OpenAutoDiagnosticTool/oadt-hardware/Jess PCB Draft Uploads/V4 Pre Feedback/README.md

File with Jess V4 upload (pre sponsor feedback)
