OpenAutoDiagnosticTool/oadt-hardware/Jess PCB Draft Uploads/V4.5 Pre Feedback/V4.5 Schematic.png

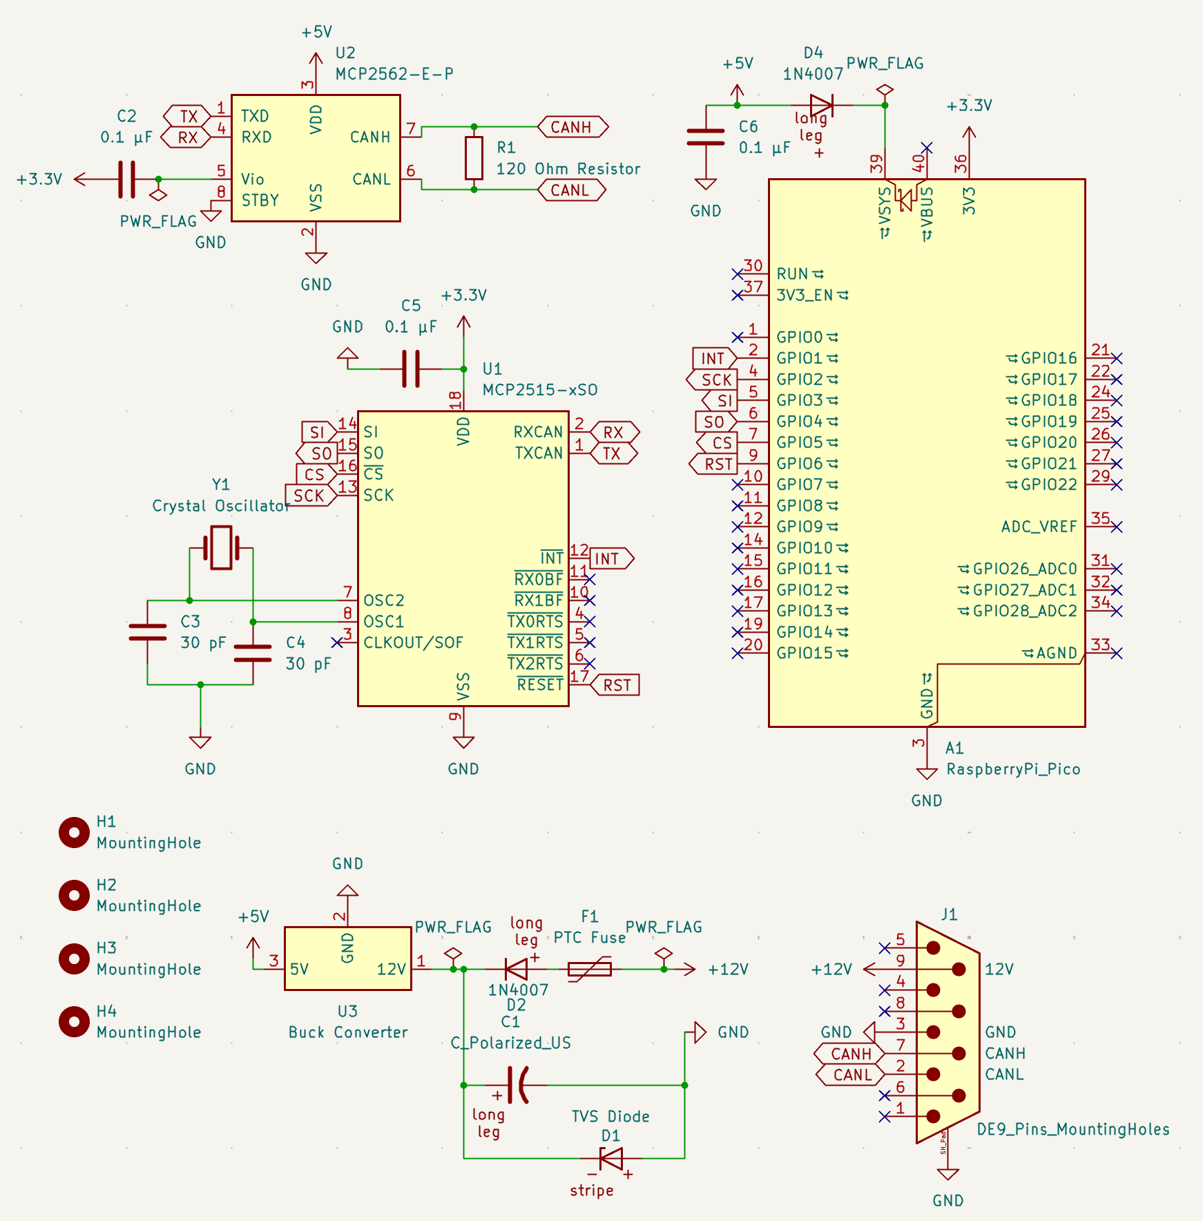
Jess PCB Draft Uploads/V4.5 Pre Feedback/V4.5 Schematic.png
