OpenAutoDiagnosticTool/oadt-hardware/Jess PCB Draft Uploads/V6.75 Post Round 1 Feedback/V6.75 PCB.png

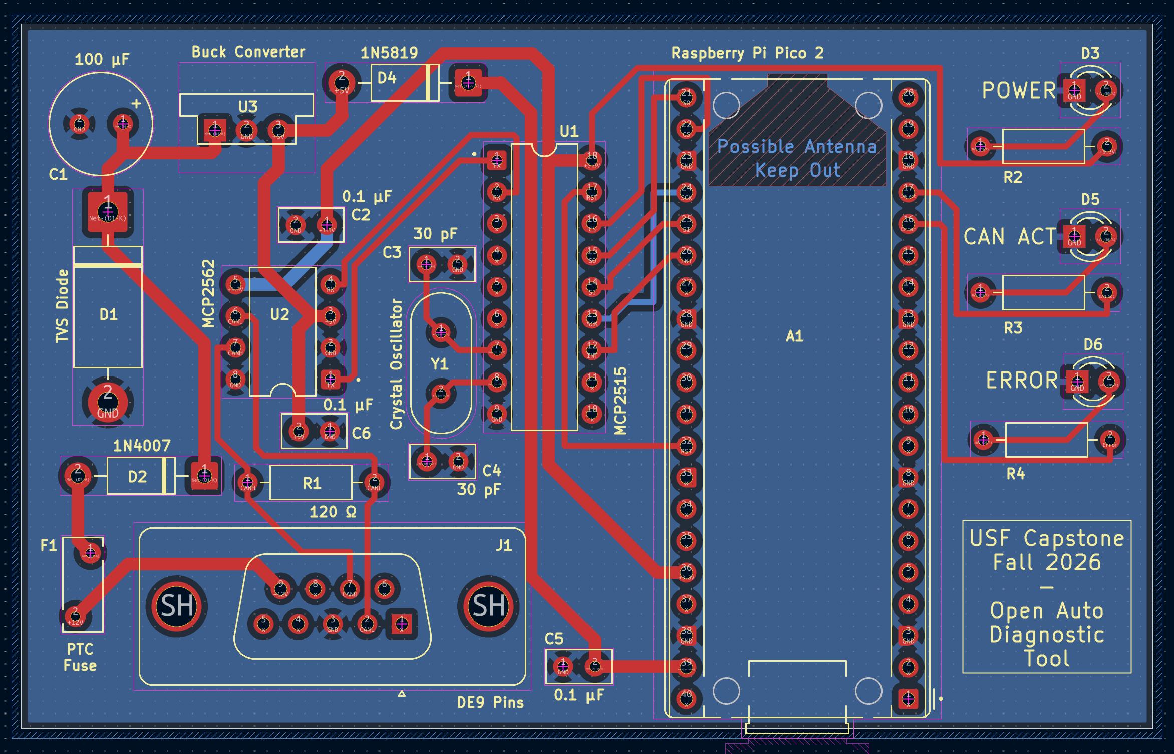
Jess PCB Draft Uploads/V6.75 Post Round 1 Feedback/V6.75 PCB.png
