OpenAutoDiagnosticTool/oadt-hardware/Sri PCB Draft Uploads/Automotive Diagnostic Device Schematic.png

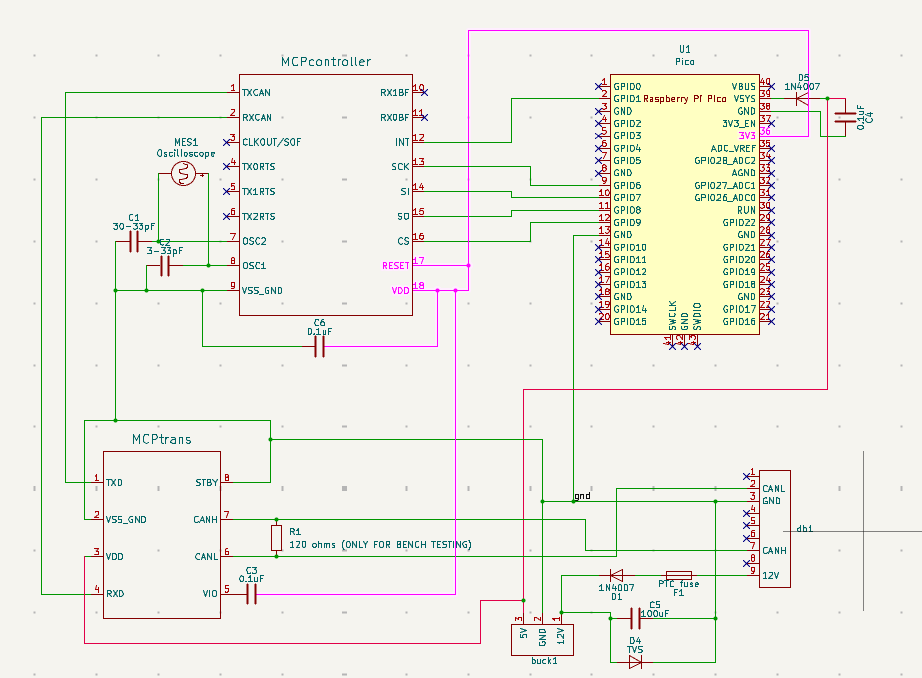
Sri PCB Draft Uploads/Automotive Diagnostic Device Schematic.png
