OpenAutoDiagnosticTool/oadt-hardware/Updated BOM 11_10_26.xlsx

Sheet: DOCUMENTS
Date | File | Notes
2026-09-01 | Capstone - 9/1 (https://docs.google.com/document/u/0/d/1Gs7xZhQPVx7Znyp6BOKTVCD1h0s4Dx-aLEvyEM8XXXg/edit) | First meeting with CyberEthos and HackerBox
2026-09-01 | Individual Milestone 1 (https://docs.google.com/document/u/0/d/1TAU1LhzQIUigBskgj52EvdWvoHsRghSwzVuRf5ABwEk/edit) | Individual Milestone 1 working doc with draft of goals
2026-09-03 | 9/3/26 Meeting Notes (https://docs.google.com/document/d/1-k9ugLh2BX3kCwyq8SMfbWg3F0UrVttjpxOlG3I75LM/edit) | BOM notes,
2026-09-03 | HW research week 2 (https://docs.google.com/document/u/0/d/1gD4UBUJpHWkavbMV75tDN7-YPKfnvkqKcxwa5hba6jA/edit) | research into power regulation and protection circuitry and for hw requirements
2026-09-04 | SRS Document - Group 9.docx (https://docs.google.com/document/d/19dAIpIsazuAdUhwxeTNlklljzbKy301O/edit) | SRS Document Due in Week #5 [DO NOT CHANGE, ARCHIVED FOR WEEK #5]
2026-09-04 | Week 3 PPT - Group 9.ppt (https://docs.google.com/presentation/d/1JEXXgFFRat8mtJlsnbYnkg4aMvGq9VBh/edit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) | Powerpoint Presentation Due in Week #3
2026-09-04 | Compiled References Document (https://docs.google.com/document/d/1ZcJcOYrFqZtFeXOmM2PsOt8LyZMZo1tms-zpK2VTVZk/edit?usp=sharing) | Shared Links & Resources Document (put Research Links Here!)
2026-09-04 | Meeting Questions - 9-8-26 (https://docs.google.com/document/d/1W8fk-RmYhKIOYWmYRygqwYv4s0_oB04zhHvXF1aAWfk/edit?usp=sharing) | Compiled questions document for the second sponsor meeting.
2026-09-07 | CSE Project Competitor Research (https://docs.google.com/spreadsheets/d/1viDQ0cnk6YH8ub9xLXvHGgaDz-HQ3stk7HNVZTzYFW0/edit?usp=sharing) | Market competition pros, cons spreadsheet.
2026-09-08 | Group 9 Status Report Week #3.docx (https://docs.google.com/document/u/0/d/1_K-ItI_vFPWTCAXE9CA6uvT8k9aT0zXq/edit) | Group Milestone Doc for Week #3 due 9/9/26
2026-09-08 | Capstone Timesheet (https://docs.google.com/spreadsheets/u/0/d/1Pm0rdnJS20I27uHih6wyGSNtpxomx7rAShTqMR9tzlI/edit) | Timesheet
2025-09-10 |  | HLA: https://drive.google.com/file/d/1Ch_KrxEQaCyk-fuzPMvXRvO8breeS8U3/view?usp=sharing
2026-09-13 | wiring diagram .pdf (https://drive.google.com/open?id=1QmO12eAfBzWXY-dWjmGoFvzyBTcD6x67) | preliminary wiring diagram
2026-09-15 | Sponsor-Group Timeline (https://docs.google.com/spreadsheets/u/0/d/1W-VPYa-jzlQ1ro1LRvJqG7ZidZEr98lkQcJk_G-nlDw/edit) | Sponsor Deliverable Timeline (Requested By Sponsors for Third Meeting)
2026-09-22 | Capstone Meeting 9/22/26 (https://docs.google.com/document/u/0/d/14cD2zF943hpWhe5fSAL3N1_-DaOxZNKaecCtNU4KPd4/edit)
2026-09-22 |  | Canva SRS Graph Link: https://canva.link/p4soid6kv4p797n
2026-09-24 | SRS_PPT_Week_5.ppt (https://docs.google.com/presentation/d/1PXgv63OLHjyN8DWKORF14GGHjIEUAp2l/edit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)
2026-09-28 | Group 9 Team Status Report Week 6 (https://docs.google.com/document/u/0/d/1SpaOilgrShMOlS1x4Hjs6kuFiKvBCBcWqZKIAeQUMtg/edit) | Weekly Team Status Report for Week #6
2026-10-01 | Detailed Design Document - Group 9 (https://docs.google.com/document/d/138Y3n-lF-r_G1akQkxaeDfNgxYNdTVmt/edit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) | Detailed Design Document Week #8
2026-10-04 | OBD-II Simulator Board Unit Testing (https://docs.google.com/document/d/1VLMCR7gnZ4T5RBzsZaPHs1VmE5JWiIFcANQ7vCqX6X0/edit?usp=sharing) | Testing & Inspection Results of Prototype #1 board and eBay simulator board.
2026-10-04 |  | Canva DDD Document Diagrams: https://canva.link/wtoogvrf2o1iumd
2026-10-11 | SRS Document - Group 9 Week #8 (https://docs.google.com/document/d/16McjUAWhfHkmRGsgXDrwKeOUGeZ0pqAyyyVbb0RX9Bc/edit?usp=sharing) | Week #8 SRS Document Update [IF YOU MAKE SIGNIFICANT CHANGES, WRITE A NOTE ON THE DATE & CHANGE FOR DOCUMENT CONTROL]
2026-10-11 | DDD Powerpoint - Week #8.ppt (https://docs.google.com/presentation/d/1w6024NBoLrOZqCJ-UO9ms8tQUPZ017g8/edit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) | Week #8 DDD Powerpoint (Goes Hand-in-Hand with Detailed Design Document)
2026-10-11 | Team 9 AI SRS Review.pdf (https://drive.google.com/file/d/1GgwA1ytYE2KyEzBP-MFHmU6emLuM2K0-/view?usp=sharing) | AI SRS Scoring from Week #5. Professor comment states to make changes according to sections 4 and 8. A few critical ones, mostly pedantic ones.
2026-10-12 | wiring audit.pdf (https://drive.google.com/open?id=1Z6oFn4v9nUcnitlLjsdUewu_gu_mUPZp) | Wiring audit (updated with changes as discussed in messages) to verify component selection and functionality, minor changes as described in doc: 1. VIO of the transceiver should go to 3.3V and needs a 0.1µf cap between VIO pin and the 3.3V source 2. 1N4007 diodes on CAN lines are unnecessary and could cause a drop in forward voltage (just remove) 3. Pins for the Pico were adjusted so all pins are SPI0 (vs split btwn SPI0 and SPI1)
2026-10-28 | Group 9 Team Status Report Week 10 (https://docs.google.com/document/u/0/d/106oGUNc0ujHek6ETwJYNIdHoj76-xSvasCnr04nFAqE/edit) | Weekly Team Status Report for Week #10
2026-11-09 | MVP Powerpoint - Week #12.ppt (https://docs.google.com/presentation/d/1naQPf0ZhSdVPa0Uvq_Tu2lEraDiBlhHj/edit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) | No report is due, just this powerpoint.
2026-11-09 | Detailed Design Document - Group 9 Week #12.docx (https://docs.google.com/document/d/1ZIA3nQWfP9A84pFIWk2JBPvDaXvIvwDa/edit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) | UPDATED VERSION OF DDD - Version #2 for MVP
2026-11-09 | SRS Document - Group 9 Week #12 (https://docs.google.com/document/d/1K19DcBLqgZFpRvsEChOMCQkJBEyk0aBOqODV7sPy9Ck/edit?usp=sharing) | UPDATED VERSION OF SRS - Version #3 for MVP
2026-11-09 | AI DDD Review Doc.docx (https://docs.google.com/document/d/1nC6-_gfiZbEkbPPOt7ErDGADY-UjA9XS/edit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) | AI-Generated DDD Review

Sheet: Availability
Time | Sunday |  |  |  | Monday |  |  |  | Tuesday |  |  |  | Wednesday |  |  |  | Thursday |  |  |  | Friday |  |  |  | Saturday
 | Jake | Jess | Justin | Sri | Jake | Jess | Justin | Sri | Jake | Jess | Justin | Sri | Jake | Jess | Justin | Sri | Jake | Jess | Justin | Sri | Jake | Jess | Justin | Sri | Jake | Jess | Justin | Sri
9 | y | n |  | y | n | n | y |  | n | n |  |  | n | n | y |  | y | n | y |  | y | n | y |  | y | n |  | y
9:30:00 | y | n |  | y | n | y | y |  | n | n |  |  | n | y | y |  | y | n | y |  | y | n | y |  | y | n |  | y
10 | y | y |  | y | n | y | y |  | n | n |  |  | n | y | y |  | y | n | y |  | y | n | y |  | y | y |  | y
10:30:00 | y | y |  | y | n | y | y |  | n | n |  |  | n | y | y |  | y | n | y |  | y | n | y |  | y | y |  | y
11 | y | y |  | y | n | y | y |  | n | y |  |  | n | y | y |  | y | y | y |  | n | n | y |  | y | y |  | y
11:30:00 | y | y |  | y | n | y | y |  | n | y |  |  | n | y | y |  | y | y | y |  | n | n | y |  | y | y |  | y
Noon | y | y |  | y | n | y | y |  | n | y |  |  | n | y | y |  | y | y | y |  | n | n | y |  | y | y |  | y
12:30:00 | y | y |  | y | n | y | y |  | n | y |  |  | n | y | y |  | n | y | y |  | n | n | y |  | y | y |  | y
1 | y | y |  | y | n | y | y |  | n | y |  |  | n | y | y |  | n | y | y |  | n | n | y |  | y | y |  | y
1:30:00 | y | y |  | y | n | y | y |  | n | y |  |  | n | y | y |  | n | y | y |  | n | n | y |  | y | y |  | y
2 | y | y |  | y | n | y | y |  | n | n |  |  | n | y | y |  | n | n | y |  | n | y | y | y | y | y |  | y
2:30:00 | y | y |  | y | n | y | y | y | y | n |  | y | n | y | y | y | n | n | y | y | n | y | y | y | y | y |  | y
3 | y | y |  | y | n | y | y | y | y | n |  | y | n | y | y | y | n | n | y | y | n | y | y | y | y | y |  | y
3:30:00 | y | y |  | y | n | y | y | y | y | n |  | y | n | y | y | y | n | n | y | y | n | y | y | y | y | y |  | y
4 | y | y |  | y | n | y | y | y | y | n |  | y | n | y | y | y | n | n | y | y | n | y | y | y | y | y |  | y
4:30:00 | y | y |  | y | n | y | y | y | y | n |  | y | n | y | y | y | n | n | y | y | n | y | y | y | y | y |  | y
5 | y | y |  | y | n | y | y | n | y | n | n | y | n | y | y | y | n | n | y | y | n | y | y | y | y | y |  | y
5:30:00 | y | y |  | y | n | y | y | n | y | n | n | y | n | y | y | y | n | n | n | y | n | y | y | y | y | y |  | y
6 | y | y |  | y | n | y | y | n | y | n | n | y | n | y | y | y | n | n | n | y | n | y | y | y | y | y |  | y
6:30:00 | y | y |  | y | n | n | y | n | y | n | n | y | n | n | y | y | n | n | n | y | n | y | y | y | y | y |  | y
7 | y | n |  | y | n | n | n | n | y | y | n | y | n | n | n | y | n | y | n | y | n | y | y | y | y | n |  | y
7:30:00 | y | n |  | y | n | n | n | n | y | y | n | y | n | n | n | y | n | y | n | y | n | y | y | y | y | n |  | y
8 | y | n |  | y | n | y | n | n | y | y | n | y | n | y | n | y | n | y | n | y | n | y | y | y | y | n |  | y
8:30:00 | y | n |  | y | n | y | n | n | y | y | y | y | n | y | n | y | n | y | y | y | n | y | y | y | y | n |  | y
Notes: | Justin - depends on my work schedule |  |  |  |  |  |  |  |  |  |  |  |  |  |  |  |  |  |  |  |  |  |  |  | Justin - depends on my work schedule

Sheet: Time Tracker
Date | People | Amt of Time (hrs) | Classification | Notes
2026-08-28 | Group | 1 | Meeting | First meeting after class on Friday
2026-08-31 | Jess | 1.5 | Individual Work | Reading about project, research on project requirements
2026-08-30 | Sri | 1 | Individual Work | Reading project document, looked at resources given by sponsors about project, created sheets for team organization
2026-08-31 | Jake | 1 | Individual Work | Reading project document, determining roles, sponsor meeting setup, firmware meeting questions.
2026-08-31 | Justin | 1 | Individual Work | Reading Project doc, and looking into PCB design basics
2026-09-01 | Jess | 2.5 | Individual Work | Determining questions for first meeting, researching requirements, start of goals for individual milestone
2026-09-01 | Group | 0.75 | Meeting | Meeting #1 with sponsors to ask preliminary questions
2026-09-01 | Jess | 0.5 | Individual Work | Making time tracker, coming up with milestone 1 goals, and uploading to notes tab
2026-09-02 | Sri | 2 | Individual Work | research and thinking about prototyping methods+timeline and success
2026-09-02 | Justin | 1 | Individual Work | Going over the timesheet and reflecting on our goals for week 2 report
2026-09-02 | Group | 1-2 on average | Individual Work | Individual Milestone 1 and associated communication
2026-09-03 | Group | 1 | Meeting | Reviwed incompleted goals this week, created goals for next week and next steps to guide work and research.
2026-09-03 | Sri | 2 | Individual Work | Researched OBD2 connector and protection circuitry
2026-09-04 | Jake | 2.5 | Individual Work | Researched CAM Firmware, Project Proposal Resource Links, Made Extra Docs
2026-09-07 | Jake | 2.5 | Individual Work | Created research documents, worked on Epic/Features, meeting questions, competitor market research.
2026-09-08 | Group | 0.75 | Meeting | Sponsor Meeting #2
2026-09-08 | Jake | 2.5 | Meeting | Clarification of Project Requirements, Next Steps, Pi Pico 2W Setup

Sheet: Requirements
Req. ID | Requirement | Rationale (story statement) | Verification method / success metric | Parent Req | Child Req | Status | Notes | Req. ID | Requirement | Rationale (story statement) | Verification method | Parent Req | Child Req | Status
FR - 1.1 | Shall connect to standard OBD-II (SAE J1962) connector. |  |  |  |  | Incomplete | Do we want to be able to interact with OBD2 B vehicles that have a higher voltage? | NFR - 1.1 | Tool shall be easy to connect and operate. |  |  |  |  | Incomplete
FR - 1.2 | Shall support ISO 15765-4 CAN signaling. |  |  |  |  | Incomplete | For Spec: will support this signalling using CAN tranciever built in to Pico board | NFR - 1.2 | Documentation shall be clear for non-experts. |  |  |  |  | Incomplete
FR - 1.3 | Shall provide regulated power from vehicle 12 V supply. |  |  |  |  | Incomplete | Could be 24V will check with sponsor | NFR - 2.1 | Hardware shall withstand automotive electrical conditions |  |  |  |  | Incomplete
FR - 1.4 | Shall include protection against reverse polarity and voltage spikes |  |  |  |  | Incomplete | For spec: need to find out what component is needed to achieve this | NFR - 2.2 | Communication shall maintain stable CAN bus operation. |  |  |  |  | Incomplete
FR - 2.1 | Shall initialize and manage CAN 2.0A/B communication |  |  |  |  | Incomplete | Should we bit bang (use processor directly for comms) or use additional communication chip? | NFR - 3.1 | Firmware shall prevent unintended ECU modification. |  |  |  |  | Incomplete
FR - 2.2 | Shall support message filtering and ID dec |  |  |  |  | Incomplete |  | NFR - 3.2 | Diagnostic commands shall be limited to safe read-only operations. |  |  |  |  | Incomplete
FR - 2.3 | Shall transmit and receive OBD-II diagnostic frames. |  |  |  |  | Incomplete |  | NFR - 4.1 | System shall allow additional protocols (e.g., K-Line, CAN-FD). |  |  |  |  | Incomplete
FR - 3.1 | Shall support OBD-II Modes 01–09. |  |  |  |  | Incomplete |  | NFR - 4.2 | Open-source design shall support community contributions |  |  |  |  | Incomplete
FR - 3.2 | Shall read and clear diagnostic trouble codes (DTCs) |  |  |  |  | Incomplete |  | NFR - 5 | Total BOM cost shall remain under a target threshold (e.g., $75–$100 per unit) |  |  |  |  | Incomplete
FR - 3.3 | Shall display or transmit sensor data (RPM, speed, temperature, etc.). |  |  |  |  | Incomplete
FR - 3.4 | Shall log communication sessions for analysis. |  |  |  |  | Incomplete
FR - 4.1 | Shall allow firmware updates via USB or serial interface. |  |  |  |  | Incomplete
FR - 4.2 | Shall support modular code structure for adding new protocols. |  |  |  |  | Incomplete
FR - 5.1 | Shall provide graphical display of live data and fault codes. | NON NECESSARY |  |  |  | Incomplete
FR - 5.2 | Shall allow data export to CSV or JSON format |  |  |  |  | Incomplete

Sheet: Task Tracker
Task | Priority | Owner | Status | Due date | Milestone | Deliverable | Notes
Bill of Materials | P3 | Justin | In progress | 2026-09-08
Schematic | P2 | Sri | Not started | 2026-09-17
Setup SRS Document | P2 | Jacob Rowe | Completed | 2026-09-05
Complete Week #3 Powerpoint | P1 | Jacob Rowe | Completed | 2026-09-10
Create Week #3 Epic, Features, Stories | P2 | Jacob Rowe | Completed | 2026-09-10
Investigate and document differences between OBD A and B. | P3 | Sri | In progress | 2026-09-10
Investigate making a simulator. | P3 | Jess | Blocked | 2026-09-10
Investigate whether CAN controller within Pico is capable of interfacing with the OBD to the level we need it to. | P3 | Justin | Not started | 2026-09-10
Complete & Present Sponsor Deliverable Timeline Document | P1 | Jacob | Blocked | 2026-09-15 |  |  | Sponsors cancelled the meeting last-minute.

Sheet: BOM New
Item name | Quantity | Price | Status | Supplier | Part Number | Notes | Total Cost
Raspberry Pi Pico 2 | 1 | 6 | Own | Digikey | SC1632 | https://www.digikey.com/en/products/detail/raspberry-pi/SC1632/26241102 | 6
MCP2515-I/P CAN Controller | 1 | 2.71 | need to order | Digikey | MCP2515-I/P-ND | https://www.digikey.com/en/products/detail/microchip-technology/MCP2515-I-P/593000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 | 2.71
MCP2562-E/P CAN Transciever | 1 | 1.31 | need to order | Digikey | MCP2562-E/P-ND | https://www.digikey.com/en/products/detail/microchip-technology/MCP2562-E-P/4079966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 | 1.31
16MHz Crystal Oscillator | 1 | 0.32 | need to order | Digikey | 3155-16M20P2/49US-ND | https://www.digikey.com/en/products/detail/yic/16M20P2-49US/15648595 | 0.32
22pF Capacitor | 2 | 0.26 | Own | Digikey | 445-174269-1-ND | https://www.digikey.com/en/products/detail/tdk/FA28C0G1H220JNU00/7384514 | 0.52
0.1µF Capacitor | 3 | 0.28 | need to order | Digikey | 445-174245-1-ND | https://www.digikey.com/en/products/detail/tdk/FA18X7R1H104KNU00/7384204 | 0.84
100µF Capacitor | 1 | 0.37 | need to order | Digikey | 399-15742-ND | https://www.digikey.com/en/products/detail/kemet/ESL107M050AGMAA/7427057 | 0.37
10k Ohm Resistor | 2 | 0.1 | Own | Digikey | 13-CFR-25JB-52-10K-ND | https://www.digikey.com/en/products/detail/yageo/CFR-25JB-52-10K/338 | 0.2
DC DC CONVERTER 5V Buck Regulator | 1 | 6 | need to order | Digikey | 811-2196-5-ND | https://www.digikey.com/en/products/detail/murata-power-solutions-inc/OKI-78SR-5-1-5-W36-C/2259781 | 6
1N4007 Rectifier Diode | 1 | 0.22 | need to order | Digikey | 5245-1N4007CT-ND | https://www.digikey.com/en/products/detail/dcomponents/1N4007/27607983?utm_source=chatgpt.com | 0.22
1.5KE20A TVS Diode | 1 | 0.9 | need to order | Digikey | 4878-1.5KE20ACT-ND | https://www.digikey.com/en/products/detail/diotec-semiconductor/1-5KE20A/22193463 | 0.9
PTC Resettable FUSE 60V 500MA | 1 | 0.47 | need to order | Digikey | MF-R050-2CT-ND | https://www.digikey.com/en/products/detail/bourns-inc/MF-R050/259965 | 0.47
OBD to DE-9 Cable | 1 | 5.95 | need to order | Digikey | 1528-4841-ND | https://www.digikey.com/en/products/detail/adafruit-industries-llc/4841/13901491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 | 5.95
3mm LED | 3 | 0.16 | Own | Digikey | 732-5008-ND | https://www.digikey.com/en/products/detail/w-rth-elektronik/151031VS06000/4489988?gclsrc=aw.ds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
120 Ohm Resistor | 3 | 0.1 | Own | Digikey | 120QBK-ND | https://www.digikey.com/en/products/detail/yageo/CFR-25JB-52-120R/389?s=N4IgTCBcDaIIxgAwEUBCBpAtAOQCIgF0BfIA
Solderable DB9 | 1 | 0.78 | need to order | Digikey | AE10970-ND | https://www.digikey.com/en/products/detail/assmann-wsw-components/A-DS-09-A-KG-T4S/1241806?gclsrc=aw.ds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
For Prototyping |  |  |  |  |  |  | 0
120 Ohm Resistor [NOTE: This is for bench testing only; if plugging into a car, this MUST be removed!] | 1 | 0.1 | Own | Digikey | 120QBK-ND | https://www.digikey.com/en/products/detail/yageo/CFR-25JB-52-120R/389?s=N4IgTCBcDaIIxgAwEUBCBpAtAOQCIgF0BfIA | 0.1
DB9 to Terminal Block Adapter | 1 | 6.25 | need to order | Digikey | 1528-4512-ND | https://www.digikey.com/en/products/detail/adafruit-industries-llc/4512/12396898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 | 6.25
18-pin DIP Socket for MCP2515 | 1 | 0.98 | need to order | Digikey | 2057-ICS-318-T-ND | https://www.digikey.com/en/products/detail/adam-tech/ICS-318-T/9832865 | 0.98
8-pin DIP Socket for MCP2562 | 1 | 0.69 | need to order | Digikey | 2057-ICS-308-T-ND | https://www.digikey.com/en/products/detail/adam-tech/ICS-308-T/9829299 | 0.69
20-pin Female Headers for Pico | 2 | 1.15 | Own | Digikey | S7018-ND | https://www.digikey.com/en/products/detail/sullins-connector-solutions/PPTC201LFBN-RC/810158 | 2.3
Simulators |  |  |  |  |  |  | 36.13
Thanksbuyer Automotive ECU Simulator (no screen) |  | 40.06 |  | Thanksbuyer | (also available for a similar price on Ebay) | https://www.thanksbuyer.com/products/automotive-ecu-simulator-obd-simulator-with-accessories-for-passenger-cars-elm327-development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
Thanksbuyer OBD II Simulator with Screen |  | 59 |  | Thanksbuyer | (also available for a similar price on Ebay) | https://www.thanksbuyer.com/products/obd-ii-simulator-obd2-ecu-simulator-with-0-96-quot-128-64-oled-screen-supports-7-conventional-protocols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

Sheet: BOM Old
Item name | Part Number | Price | supplier | Status | Notes | Column 1
obd2 to db9 cord |  | 6.9 |  |  | https://www.digikey.com/en/products/detail/dfrobot/FIT0429/7597204
male db9 on board |  | 0.79 |  |  | https://www.digikey.com/en/products/detail/assmann-wsw-components/A-DS-09-PP-Z-BK/10668847?gclsrc=aw.ds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
Soldering Iron |  |  |  |  | Team-supplied
Breadboard |  |  |  |  | Team-supplied
Protoboard |  |  |  |  | Team-supplied
Raspberry Pi Pico 2 |  | 6.25 |  |  | https://www.adafruit.com/product/6006
PPTC Fuse |  | 0.4 |  |  | https://www.mouser.com/en/ProductDetail/Bourns/MF-R050?qs=A6omU7D3gEWzJRzbTsuTwA%3D%3D&mgh=1
Schottky Diode |  | 0.6 |  |  | https://www.digikey.com/en/products/detail/vishay-general-semiconductor-diodes-division/SS1H10-E3-61T/1091541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
TVS Diode |  |  |  |  | https://us.rs-online.com/product/littelfuse/smcj33a/70519330/
Buck Regulator Module |  |  |  |  | https://www.droking.com/DC-Step-Down-Voltage-Regulator-DC-12-24V-to-5V-5A-25W-Buck-Converter-Module-Waterproof-Car-Power-Supply
RECOMMMENDED CAN protocol controller with tranceiver | MCP 25625 | 3.8 | Digikey | need to order | https://www.digikey.com/en/products/detail/microchip-technology/MCP25625-E-SS/4842805
DIP TRANSCEIVER (: | MCP2561-H/P |  | Digikey | need to order | https://www.digikey.com/en/products/detail/microchip-technology/MCP2561-H-P/4079963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
[Jake] CAN-FD Compatible CAN Transceiver | 1 | 1.5 |  | Digikey | MCP2562FD-H/P | https://www.digikey.com/en/products/detail/microchip-technology/MCP2562FD-H-P/4860102
