OpenAutoDiagnosticTool/oadt-hardware/Sri PCB Draft Uploads/Capstone V2 nets.kicad_pcb

## KiCad design Sri PCB Draft Uploads/Capstone V2 nets.kicad_pcb (2026-11-11)

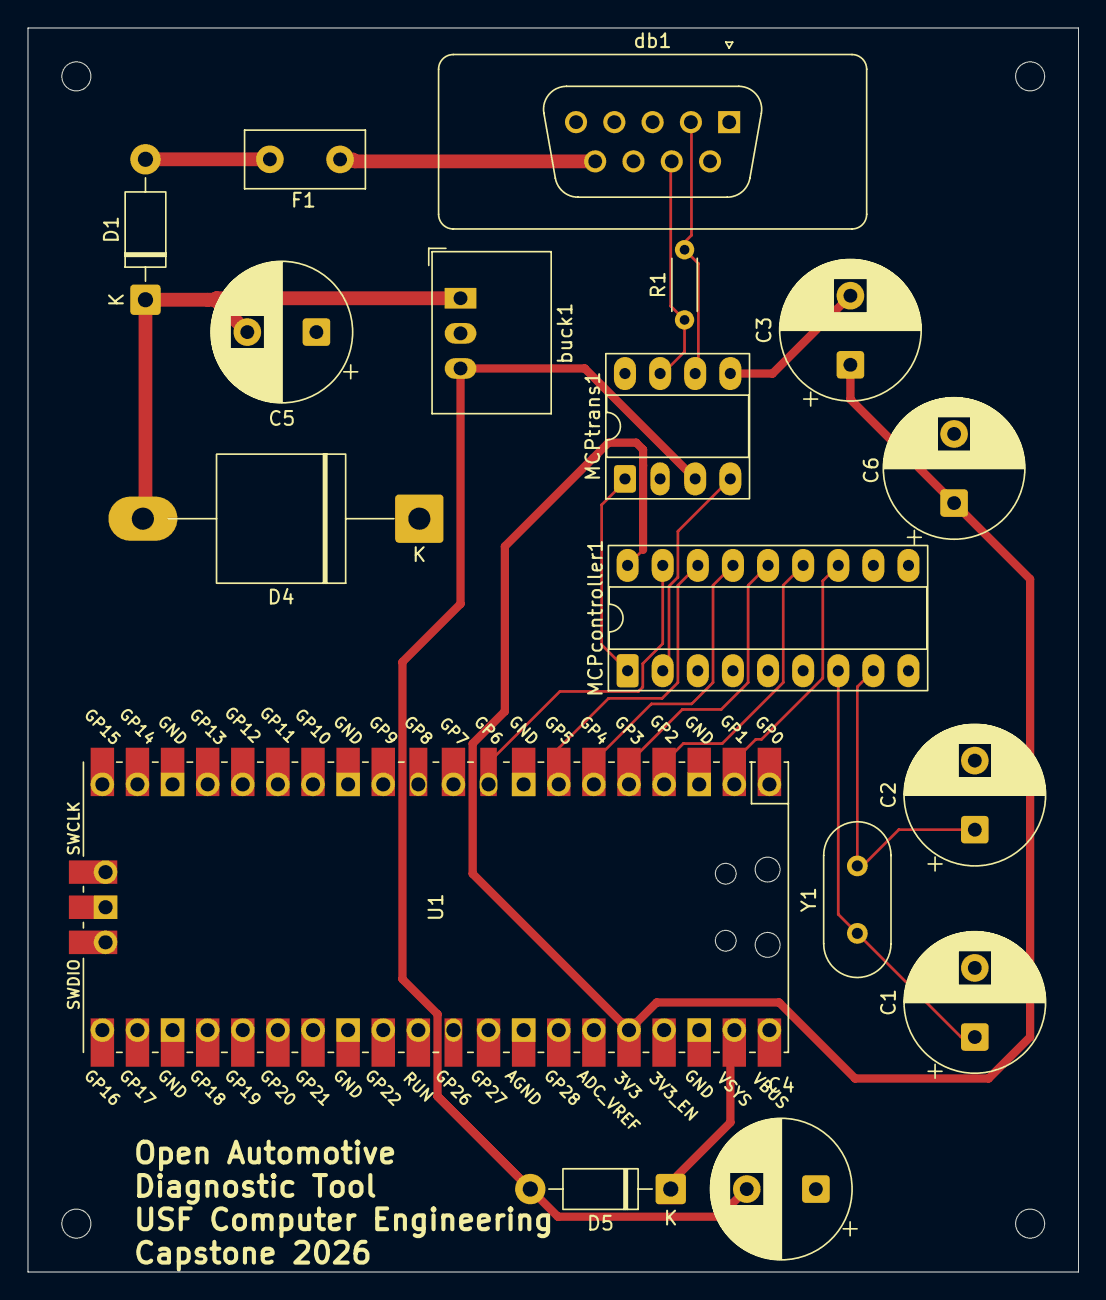
[picture p6: board Capstone V2 nets.kicad_pcb from above]

Board: 2 copper layers, 76.0 x 90.0 mm, 17 parts (0 on the bottom side), 20 nets.

Parts:
C1: 30-33pF; CP_Radial_D10.0mm_P5.00mm
C2: 3-33pF; CP_Radial_D10.0mm_P5.00mm
C3, C4, C6: 0.1uF; CP_Radial_D10.0mm_P5.00mm
C5: 100uF; CP_Radial_D10.0mm_P5.00mm
D1, D5: 1N4007; D_DO-41_SOD81_P10.16mm_Horizontal
D4: TVS; D_P600_R-6_P20.00mm_Horizontal
F1: PTC fuse; Fuse_Littelfuse_395Series
MCPcontroller1: DIP-18_W7.62mm_Socket_LongPads
MCPtrans1: DIP-8_W7.62mm_Socket_LongPads
R1: 120 ohms (ONLY FOR BENCH TESTING); R_Axial_DIN0204_L3.6mm_D1.6mm_P5.08mm_Horizontal
U1: Pico; RPi_Pico_TH
Y1: Crystal; Crystal_HC49-4H_Vertical
buck1: Converter_DCDC_RECOM_R-78E-0.5_THT
db1: DSUB-9_Socket_Vertical_P2.77x2.84mm

Connections:
/3v3: C3.1, C6.1, MCPcontroller1.18 (VDD), U1.36 (3V3)
/5v: C4.2, D5.2 (A), MCPtrans1.3 (VDD), buck1.3 (5V)
/12v: F1.1, db1.9 (12V)
/CANH: MCPtrans1.7 (CANH), R1.1, db1.7 (CANH)
/CANL: MCPtrans1.6 (CANL), R1.2, db1.2 (CANL)
/GND: C1.2, C2.2, C4.1, C5.1, C6.2, D4.1 (K), MCPcontroller1.9 (VSS_GND), MCPtrans1.2 (VSS_GND), MCPtrans1.8 (STBY), U1.3 (GND), U1.8 (GND), U1.13 (GND), U1.38 (GND), buck1.2 (GND), db1.3 (GND)
/INTERRUPT: MCPcontroller1.12 (INT), U1.2 (GPIO1)
/RESET: MCPcontroller1.17 (RESET), U1.9 (GPIO6)
/RXCAN: MCPcontroller1.2 (RXCAN), MCPtrans1.4 (RXD)
/SPI CLK: MCPcontroller1.13 (SCK), U1.4 (GPIO2)
/SPI CS: MCPcontroller1.16 (CS), U1.7 (GPIO5)
/SPI MISO: MCPcontroller1.15 (SO), U1.6 (GPIO4)
/SPI MOSI: MCPcontroller1.14 (SI), U1.5 (GPIO3)
/TXCAN: MCPcontroller1.1 (TXCAN), MCPtrans1.1 (TXD)
unnamed: D1.2 (A), F1.2
unnamed: C5.2, D1.1 (K), D4.2 (A), buck1.1 (12V)
unnamed: D5.1 (K), U1.39 (VSYS)
unnamed: C2.1, MCPcontroller1.8 (OSC1), Y1.2
unnamed: C1.1, MCPcontroller1.7 (OSC2), Y1.1
unnamed: C3.2, MCPtrans1.5 (VIO)
