OpenAutoDiagnosticTool/oadt-hardware/Jess PCB Draft Uploads/V6.75 Post Round 1 Feedback/Capstone PCB Design V6.75.kicad_pcb

## KiCad design Jess PCB Draft Uploads/V6.75 Post Round 1 Feedback/Capstone PCB Design V6.75.kicad_pcb (2026-11-11)

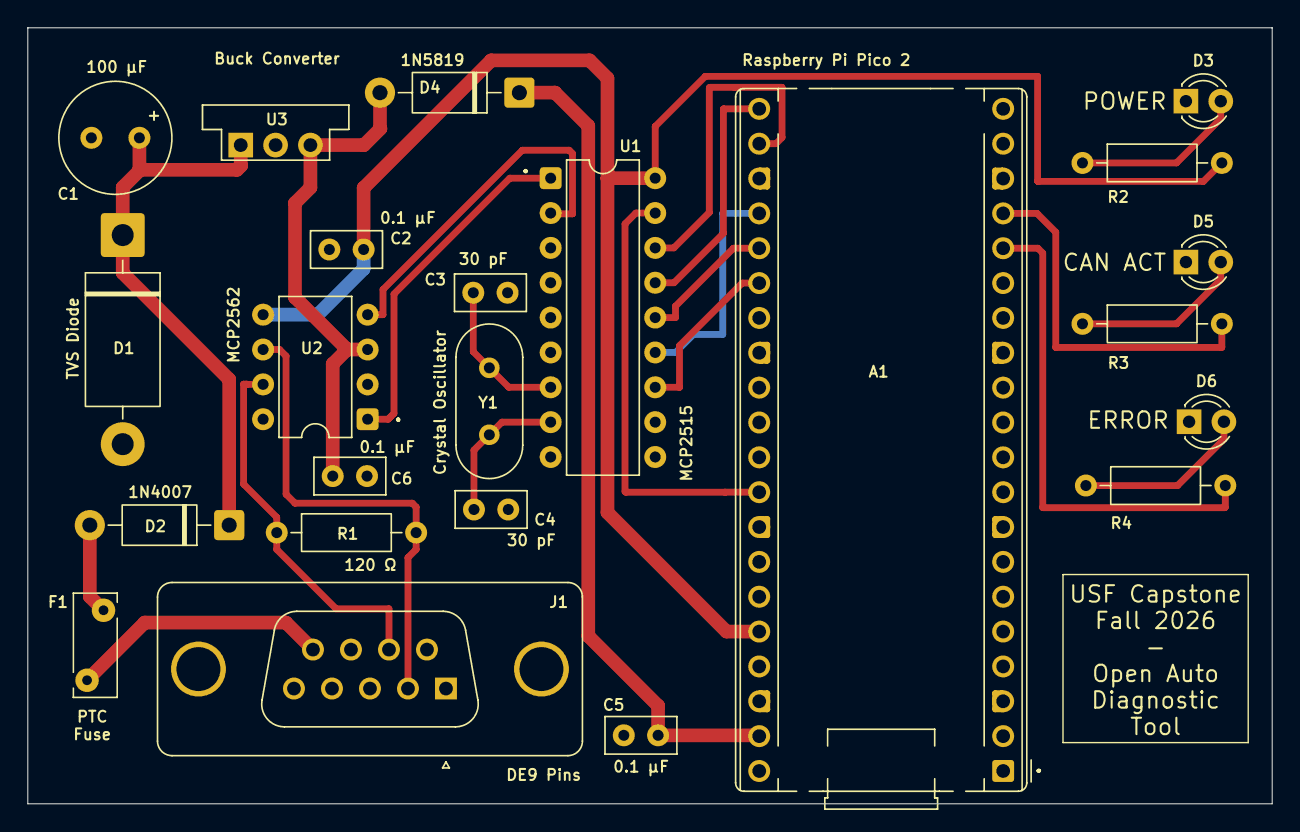
[picture p7: board Capstone PCB Design V6.75.kicad_pcb from above]

Board: 2 copper layers, 90.7 x 56.6 mm, 27 parts (0 on the bottom side), 24 nets.

Parts:
A1: RaspberryPi_Pico; RaspberryPi_Pico_Common_THT
C1: C_Polarized_US; C_Radial_D8.0mm_H11.5mm_P3.50mm
C2, C5, C6: 0.1 µF; C_Disc_D5.0mm_W2.5mm_P2.50mm
C3, C4: 30 pF; C_Disc_D5.0mm_W2.5mm_P2.50mm
D1: TVS Diode; D_DO-201AD_P15.24mm_Horizontal
D2: 1N4007; D_DO-41_SOD81_P10.16mm_Horizontal
D3, D5, D6: LED; LED_D3.0mm
D4: 1N5819; D_DO-41_SOD81_P10.16mm_Horizontal
F1: PTC Fuse; Fuse_Bourns_MF-RHT050
H1, H2, H3, H4: MountingHole; MountingHole_4.3mm_M4
J1: DE9_Pins_MountingHoles; DSUB-9_Pins_Vertical_P2.77x2.84mm_MountingHoles
R1, R2, R3, R4: 120 Ohm Resistor; R_Axial_DIN0207_L6.3mm_D2.5mm_P10.16mm_Horizontal
U1: MCP2515-xSO; DIP-18_W7.62mm
U2: MCP2562-E-P; DIP-8_W7.62mm
U3: Buck Converter; Converter_DCDC_Murata_OKI-78SR_Vertical
Y1: Crystal Oscillator; Crystal_HC49-4H_Vertical

Connections:
+3.3V: A1.36 (3V3), C2.1, R2.2, U1.18 (VDD), U2.5 (Vio)
+5V: C6.2, D4.2 (A), U2.3 (VDD), U3.3 (5V)
+12V: F1.2, J1.9 (12V)
CAN Act: A1.17 (GPIO13), R3.2
CANH: J1.7 (CANH), R1.1, U2.7 (CANH)
CANL: J1.2 (CANL), R1.2, U2.6 (CANL)
CS: A1.22 (GPIO17), U1.16 (~CS)
Error: A1.16 (GPIO12), R4.2
GND: A1.3 (GND), A1.8 (GND), A1.13 (GND), A1.18 (GND), A1.23 (GND), A1.28 (GND), A1.38 (GND), C1.2, C2.2, C3.2, C4.2, C5.1, C6.1, D1.2 (A), D3.1 (K), D5.1 (K), D6.1 (K), J1.3 (GND), U1.9 (VSS), U2.2 (VSS), U2.8 (STBY), U3.2 (GND)
INT: A1.26 (GPIO20), U1.12 (~INT)
unnamed: A1.39 (VSYS), C5.2, D4.1 (K)
unnamed: C1.1, D1.1 (K), D2.1 (K), U3.1 (12V)
unnamed: D2.2 (A), F1.1
unnamed: D3.2 (A), R2.1
unnamed: D5.2 (A), R3.1
unnamed: D6.2 (A), R4.1
unnamed: C4.1, U1.8 (OSC1), Y1.2
unnamed: C3.1, U1.7 (OSC2), Y1.1
RST: A1.32 (GPIO27_ADC1), U1.17 (~RESET)
RX: U1.2 (RXCAN), U2.4 (RXD)
SCK: A1.24 (GPIO18), U1.13 (SCK)
SI: A1.25 (GPIO19), U1.14 (SI)
SO: A1.21 (GPIO16), U1.15 (SO)
TX: U1.1 (TXCAN), U2.1 (TXD)
