OpenAutoDiagnosticTool/oadt-hardware/(commit log)

2026-10-26 Jess PCB Upload
    [Capstone PCB Design V4.kicad_pcb, Capstone PCB Design V4.kicad_sch]
2026-10-26 added folders to increase organization
    [Capstone PCB Design V4.kicad_pcb, Capstone PCB Design V4.kicad_sch, Capstone V1.kicad_sch]
2026-10-26 added one more folder
    [Capstone PCB Design V4.kicad_pcb, Capstone PCB Design V4.kicad_sch]
2026-10-27 uploaded improved V4.5 PCB files
    [Capstone PCB Design V4-B_Cu.gbl, Capstone PCB Design V4-B_Mask.gbs, Capstone PCB Design V4-B_Paste.gbp, Capstone PCB Design V4-B_Silkscreen.gbo, Capstone PCB Design V4-Edge_Cuts.gm1, Capstone PCB Design V4-F_Cu.gtl, Capstone PCB Design V4-F_Mask.gts, Capstone PCB Design V4-F_Paste.gtp]
2026-10-27 updated file names to reflect version number
    [Capstone PCB Design V4.5-B_Cu.gbl, Capstone PCB Design V4.5-B_Mask.gbs, Capstone PCB Design V4.5-B_Paste.gbp, Capstone PCB Design V4.5-B_Silkscreen.gbo, Capstone PCB Design V4.5-Edge_Cuts.gm1, Capstone PCB Design V4.5-F_Cu.gtl, Capstone PCB Design V4.5-F_Mask.gts, Capstone PCB Design V4.5-F_Paste.gtp]
2026-11-11 Uploaded V6.75 PCB for feedback with images
    [Capstone PCB Design V6.75-B_Cu.gbl, Capstone PCB Design V6.75-B_Mask.gbs, Capstone PCB Design V6.75-B_Paste.gbp, Capstone PCB Design V6.75-B_Silkscreen.gbo, Capstone PCB Design V6.75-Edge_Cuts.gm1, Capstone PCB Design V6.75-F_Cu.gtl, Capstone PCB Design V6.75-F_Mask.gts, Capstone PCB Design V6.75-F_Paste.gtp]
2026-11-11 updated BOM upload
    [Updated BOM 11_10_26.xlsx]
